baehyeon0420-star/energy-harvesting-research/experiment-logs/experiment-log-2026-08-14.md

# 자연광 에너지 하베스팅 기반 저전력 환경 모니터링 시스템 — 실험 기록

**작성일**: 2026-08-17
**대상 연구계획서**: 자연광 에너지 하베스팅 기반 슈퍼커패시터 및 충전식 배터리의 저장 특성 비교 및 저전력 환경 모니터링 시스템 적용 가능성 평가

---

## 1. 개발 환경 구축

- Arduino IDE 2.3.10 설치
- ESP32 보드 패키지 추가 (Boards Manager URL: `https://raw.githubusercontent.com/espressif/arduino-esp32/gh-pages/package_esp32_index.json`)
- 보드: ESP32 Dev Module (HG-ESP32-DEVKIT V4, ESP32-WROOM-32E)
- 연결: USB-C(C to C) 케이블

---

## 2. ESP32-컴퓨터 연결 확인

Blink 예제에서 `LED_BUILTIN` 미정의 컴파일 에러 발생 → `#define LED_BUILTIN 2`로 해결. 이후 보드에 사용자 LED가 없는 것으로 판단되어 시리얼 출력 방식으로 검증 전환.

```cpp
void setup() {
  Serial.begin(115200);
}

void loop() {
  Serial.println("연결 확인 중...");
  delay(1000);
}
```

**결과**: 1초 간격 정상 출력 확인.

---

## 3. DHT22 (온습도센서) 테스트

- 라이브러리: Adafruit DHT sensor library v1.4.7
- 배선: DATA → GPIO4, VCC → 3.3V, GND → GND

```cpp
#include <DHT.h>
#define DHTPIN 4
#define DHTTYPE DHT22
DHT dht(DHTPIN, DHTTYPE);

void setup() {
  Serial.begin(115200);
  dht.begin();
}

void loop() {
  float h = dht.readHumidity();
  float t = dht.readTemperature();
  if (isnan(h) || isnan(t)) {
    Serial.println("DHT22 읽기 실패");
  } else {
    Serial.print("습도: "); Serial.print(h);
    Serial.print(" %  온도: "); Serial.print(t);
    Serial.println(" C");
  }
  delay(2000);
}
```

**결과**: 습도 32.5~32.6%, 온도 29.1℃ 안정적 측정.

---

## 4. 정전용량식 센서(상시 구동형) 테스트

- 배선: OUT → GPIO34(ADC), VCC → 3.3V, GND → GND

```cpp
#define CAP_SENSOR_PIN 34
void setup() { Serial.begin(115200); }
void loop() {
  int raw = analogRead(CAP_SENSOR_PIN);
  Serial.print("센서 raw 값: ");
  Serial.println(raw);
  delay(1000);
}
```

**결과**: 건조 상태 raw≈3300~3400, 손으로 파지 시 raw≈2500 → 자극 반응 확인.

---

## 5. INA219 (전류센서) 테스트

- 라이브러리: Adafruit INA219 v1.2.3
- 배선: SDA → GPIO21, SCL → GPIO22, VCC → 3.3V, GND → GND

```cpp
#include <Wire.h>
#include <Adafruit_INA219.h>

Adafruit_INA219 ina219;
bool found = false;

void setup() {
  Serial.begin(115200);
  delay(500);
  found = ina219.begin();
}

void loop() {
  if (!found) {
    Serial.println("INA219를 찾을 수 없습니다.");
    delay(1000);
    return;
  }
  float busVoltage = ina219.getBusVoltage_V();
  float current_mA = ina219.getCurrent_mA();
  Serial.print("전압: "); Serial.print(busVoltage);
  Serial.print(" V, 전류: "); Serial.print(current_mA);
  Serial.println(" mA");
  delay(1000);
}
```

**I2C 스캐너 (진단용, 문제 발생 시 사용)**:
```cpp
#include <Wire.h>
void setup() {
  Serial.begin(115200);
  Wire.begin(21, 22);
  delay(500);
  Serial.println("I2C 스캔 시작");
}
void loop() {
  byte count = 0;
  for (byte addr = 1; addr < 127; addr++) {
    Wire.beginTransmission(addr);
    byte error = Wire.endTransmission();
    if (error == 0) {
      Serial.print("발견된 주소: 0x");
      Serial.println(addr, HEX);
      count++;
    }
  }
  if (count == 0) Serial.println("아무 장치도 못 찾음");
  delay(3000);
}
```

**결과**: 전압/전류 정상 출력, 통신 정상 확인.

### 트러블슈팅 메모
- 최초 I2C 미검출 원인: DHT22를 INA219로 착각하고 테스트했던 것으로 판명
- 이후 전압이 8.10V/0mA처럼 "전압은 있는데 전류가 0"으로 뜨는 현상 반복 발생 → **회로가 물리적으로 열려있다는 신호**(개방회로)였음. 원인은 대부분 헐거운 점퍼선 접촉, 또는 브레드보드 A~E/F~J 블록을 혼동해서 다른 블록에 연결한 경우였음

---

## 6. 태양전지 발전 특성 측정 (연구계획서 3.3절)

- 회로: `태양전지(+) → INA219 Vin+ → [INA219] → Vin- → 저항 220Ω → 태양전지(-)`
- 측정일: 2026-08-17(흐림), 2026-08-25(맑음, 직사광선 재측정)

### 결과
- **흐린 날 창가 자연광 + 220Ω 부하**: 전압 0.00V, 전류 0.00mA (검출 안 됨)
- **스마트폰 손전등 대조실험** (약 5cm 거리):

| 조사 조건 | 전압(V) | 전류(mA) |
|---|---|---|
| 근접 조사 (~5cm) | 0.00~0.02 | 0.90 (최댓값) |
| 거리 이격 | 0.00~0.02 | 0.40~0.60 |

- **맑은 날 직사광선 + 220Ω 부하** (2026-08-25): 전압 0.00V(아래 해석 참고), 전류 **평균 약 28.6mA** (28.50~28.90mA 범위, 16회 연속 측정에서 안정적으로 유지)

### 결과 종합

| 조건 | 전류 |
|---|---|
| 흐린 날 창가 (220Ω 부하) | 0.00 mA (미검출) |
| 흐린 날 + 손전등 근접 | 최대 0.90 mA |
| **맑은 날 직사광선 (220Ω 부하)** | **평균 약 28.6 mA** |

### 해석
흐린 날 조건에서는 220Ω 부하 기준 유효 발전량이 관측되지 않았으나, 손전등 대조실험으로 광원 거리(광량)에 비례해 전류가 반응함을 확인 → **회로 및 태양전지 자체는 정상 작동**. 맑은 날 직사광선 조건에서는 흐린 날 손전등 대조실험 최댓값(0.90mA) 대비 **약 30배 이상 높은 전류(28.6mA)**가 안정적으로 측정되어, 광량(발전 조건)이 태양전지 발전량에 미치는 영향이 매우 크다는 것을 실측으로 확인함. 이는 자연광 하베스팅 시스템에서 **날씨(흐림/맑음)에 따른 발전량 변동성이 매우 크므로, 저장소자(슈퍼커패시터)를 통한 에너지 버퍼링이 필수적**이라는 근거를 강화함.

전압이 0.00V로 측정되는 것은 태양전지가 발전을 안 해서가 아니라, 이 회로(태양전지-INA219-저항의 독립 폐회로)가 INA219의 GND 기준점과 전기적으로 분리되어 있어 **버스전압 측정 자체가 의미가 없는 구조**이기 때문임(전류값은 V+/V- 차동 측정이라 이 문제와 무관하게 정확함).

### 개방전압(Voc) 측정 (2026-08-25)

- 회로 변경: 저항 제거, 태양전지(-) → GND 직결, INA219 Vin-는 아무 곳에도 연결하지 않고 개방 → 부하 없이 전압만 측정
- 측정 조건: 직사광선

| 항목 | 값 |
|---|---|
| 개방전압(Voc) | 약 6.31~6.32 V (안정적) |
| 전류 | 0mA 근처 (무부하이므로 정상) |

**해석**: 220Ω 부하 조건에서 역산한 전압(28.6mA × 220Ω ≈ 6.29V)이 개방전압(6.32V)과 거의 동일함 → **220Ω 부하가 이 태양전지 입장에서는 사실상 무시할 만한 가벼운 부하**였다는 뜻. 즉 실제 단락전류(Isc, 최대 전류)는 220Ω 조건에서 측정한 28.6mA보다 훨씬 클 가능성이 높음.

### 최대출력점(MPP) 탐색 — 부하저항 스윕 (2026-08-25)

- 목적: 220Ω 부하가 사실상 무부하 수준이었다는 위 관찰에 따라, 부하저항을 낮춰가며 실제 전력이 최대가 되는 지점을 탐색
- 방법: 동일 회로(태양전지+ → Vin+ → Vin- → 저항 → 태양전지-)에서 저항값만 220Ω → 150Ω → 100Ω → 10Ω으로 변경, 각 조건에서 전류(I) 측정
- 계산: 저항이 유일한 부하이므로 전압은 옴의 법칙으로 역산(`V = I × R`), 전력은 `P = V × I`(= `I²R`)로 계산. 두 방식(V×I, I²R)으로 교차검산하여 일치 확인
- **주의(트러블슈팅)**: 실외/창가 자연광은 짧은 시간에도 조도가 변동하여, 서로 다른 시점에 잰 저항값끼리는 직접 비교가 어려움을 확인함(예: 100Ω을 약해진 빛에서 먼저 재고 220Ω을 그 직후 같은 조도로 다시 재보니 100Ω보다 오히려 낮은 전류가 나옴). **동일 조도 조건에서 연속으로 재측정**하여 아래 결과를 확보함

#### 결과 (강한 직사광선, 동일 조도 조건에서 연속 측정)

| 부하저항 | 평균 전류(I) | 역산 전압(V=I×R) | 전력(P=V×I=I²R) |
|---|---|---|---|
| 220Ω | 28.6 mA | 6.292 V | 179.95 mW |
| 150Ω | 41.8 mA | 6.270 V | 262.09 mW |
| **100Ω** | 58.3 mA | 5.830 V | **339.89 mW** ← 최고점 |
| 10Ω | 71.0 mA | 0.710 V | 50.41 mW |

#### 해석
전류는 저항이 낮아질수록 계속 증가했지만(28.6→41.8→58.3→71.0mA), **전력은 100Ω에서 최댓값을 찍고 10Ω에서 크게 감소**함 — 전형적인 태양전지 I-V 곡선의 종형(bell-shaped) 출력 특성을 실측으로 확인함.

역산 전압을 보면 원인이 뚜렷함: **220Ω→100Ω까지는 전압이 6.29V→5.83V로 거의 유지**되다가, **100Ω→10Ω 구간에서 전압이 5.83V→0.71V로 폭락**함. 반면 이 구간 전류는 58.3→71.0mA로 22%만 증가함. 즉 태양전지가 낼 수 있는 최대 전류(단락전류 Isc)에 가까워지면서, 부하저항을 더 낮춰도 전류는 조금밖에 못 늘어나는데 전압만 크게 깎이는 "무릎(knee)" 구간을 100Ω과 10Ω 사이에서 넘어선 것으로 해석됨. **이 태양전지·조도 조건에서 최대출력점(MPP)은 100Ω 근방**으로 추정됨.

**부가 발견 — 조도에 따른 MPP 저항 이동**: 스윕 도중 조도가 약해졌을 때 별도로 220Ω과 100Ω을 같은 조건에서 비교한 결과, 약한 빛에서는 오히려 220Ω(약 0.61mW)이 100Ω(약 0.42mW)보다 전력이 높았음. 즉 **광량이 강할수록 최적 부하저항이 낮아지고, 광량이 약할수록 최적 부하저항이 높아지는 경향**을 실측으로 확인함. 이는 실제 충전회로 설계 시 고정 저항이 아닌 조도 변화에 대응하는 MPPT(최대출력점 추적) 회로가 필요한 이유를 뒷받침하는 근거로 활용 가능.

**한계**: 10Ω과 100Ω 사이 값(보유 저항 키트 기준 다음 단계가 없음)을 측정하지 못해 정확한 MPP 지점은 100Ω 근방으로 추정만 가능함. 저항 조합(직렬/병렬)을 이용한 중간값 측정, 안정적으로 맑은 날 재현 측정은 후속 과제로 남김.

---

## 7. 슈퍼커패시터 충전 특성 측정 (연구계획서 3.4절)

- 부품: SC5R5105ZC (5.5V / 1.0F)
- 회로: `3.3V(ESP32) → INA219 Vin+ → [INA219] → Vin- → 저항 220Ω → 슈퍼커패시터(+) / 슈퍼커패시터(-) → GND`
- 측정일: 2026-08-17

### 결과

| 경과시간 | 충전전류 |
|---|---|
| 0분 | 14.20 mA |
| 1분 | 9.50 mA |
| 2분 | 7.30 mA |
| 3분 | 6.15 mA |
| 5분 | 4.20 mA |
| 10분 | 2.00 mA |
| 14분 | 0.95 mA |
| 15분 | 0.61 mA |
| 20분 | 0.34 mA |

### 해석
- 초기 전류(14.20mA)는 이론값(3.3V ÷ 220Ω ≈ 15mA)과 근접
- 시간에 따라 지수적으로 감소하는 전형적 RC 충전 곡선 형태
- 20분 시점 전류(0.34mA)가 무부하 노이즈 수준(~0.2~0.3mA)에 근접 → **사실상 충전 완료로 판단**
- 실측 시정수(τ)가 이론값(RC=220초≈3.7분)보다 큰 것은 점퍼선 접촉저항 등 부가 저항 성분에 기인한 것으로 추정

### 결론
슈퍼커패시터는 220Ω 부하 기준 약 20분 이내에 충전 완료. 다음 단계로 방전 특성 측정을 통해 저장된 에너지의 실사용 가능성을 확인할 예정.

---

## 8. 슈퍼커패시터 방전 특성 측정 (2026-08-19)

- 부품: SC5R5105ZC (5.5V / 1.0F), 충전 완료 상태(약 3.14~3.30V)에서 시작
- 회로: `커패시터(+) → 저항 220Ω → Vin- → [INA219] → Vin+ → ESP32 GND / 커패시터(−) → ESP32 GND(별도 핀)`
  - 충전 때와 달리 외부 전원을 완전히 분리하고, 커패시터 자신이 저항을 통해 방전하도록 구성
  - Vin+/Vin- 방향이 충전 때와 반대로 연결되어 전류값이 음수(−)로 측정됨 → **절댓값을 실제 방전전류로 사용**
- 코드: `arduino-code/06_supercap_discharge_test.ino` (경과시간·전압·전류를 CSV 형태로 시리얼 출력)

### 결과

| 경과시간 | 방전전류(절댓값) |
|---|---|
| 0분 | 13.20 mA |
| 약 1.5분 | 9.70 mA |
| 약 3.1분 | 7.10 mA |
| 약 3.6분 | 6.50 mA |
| 약 5.9분 | 4.15 mA |
| 약 12.7분 | 1.01 mA |
| 약 22.9분 | 0.20 mA |

### 해석
- 초기 방전전류(13.20mA)는 충전 완료 시점 전압(약 3.14V) 기준 이론값(3.14V÷220Ω≈14.3mA)과 유사한 수준에서 시작
- 시간에 따라 지수적으로 감소하는 전형적 RC 방전 곡선 형태 (충전 곡선과 대칭적인 개형)
- 약 22.9분 시점에 전류가 0.20mA로 무부하 노이즈 수준까지 감소 → **방전 완료로 판단**
- 방전 소요시간(~23분)이 충전 소요시간(~20분)과 비슷한 수준으로, 동일 저항(220Ω) 부하 기준 충·방전 시정수가 대략 대칭적임을 확인

### 결론
슈퍼커패시터는 220Ω 부하 기준 충전(~20분)과 방전(~23분)이 비슷한 시간 내에 이루어지며, 이는 슈퍼커패시터가 빠른 충·방전이 가능한 저장소자임을 실험적으로 뒷받침함. 다만 절대적인 저장 에너지량은 크지 않아(1.0F, 3.3V 기준 E=½CV²≈5.4J), 장시간 전력 공급보다는 순간적인 부하 대응(예: 무선 통신 순간 전류 보조)에 적합할 것으로 판단됨. LIR2032와의 비교를 통해 이 역할 분담의 타당성을 추후 검증할 예정.

---

## 9. ESP32 센서부 소비전력 측정 — DHT22 (2026-08-20)

- 회로: `+레일 → INA219 Vin+ → [INA219] → Vin- → DHT22 VCC("+") / DHT22 GND, DATA(GPIO4)는 기존과 동일`
- 코드: DHT22 읽기 직전(대기 상태)과 직후(측정 순간)의 INA219 전류를 각각 기록
- 표본 수: 64개

### 결과

| 상태 | 평균 전류 | 범위 |
|---|---|---|
| 대기 상태 | 약 0.00 mA | 노이즈 수준(±0.2mA), 사실상 측정 한계 이하 |
| 센서 측정 순간 | 약 0.90 mA | 0.70 ~ 1.30 mA |

### 해석
DHT22는 대기 중에는 전류를 거의 소비하지 않다가, 실제 온습도 측정을 수행하는 순간에만 약 0.9mA 수준으로 전류가 상승하는 저전력 센서 특성을 실측으로 확인함. 이는 DHT22 데이터시트에 기재된 특성과 부합하며, ESP32의 Deep Sleep 활용 시 센서 측정 구간에서만 짧게 전류가 소모되도록 설계하는 것이 전력 절감에 효과적임을 뒷받침함.

---

## 10. ESP32 센서부 소비전력 측정 — 정전용량식 센서(상시 구동형) (2026-08-20)

- 회로: `+레일 → INA219 Vin+ → [INA219] → Vin- → 정전용량식 센서 VCC / 정전용량식 센서 GND, OUT(GPIO34)는 기존과 동일`
- 코드: `analogRead()` 직전(대기 상태)과 직후(측정 순간)의 INA219 전류를 각각 기록
- 표본 수: 8개

### 결과

| 상태 | 평균 전류 | 범위 |
|---|---|---|
| 대기 상태 | 약 6.95 mA | 6.90 ~ 7.10 mA |
| 측정 순간 | 약 6.93 mA | 6.70 ~ 7.30 mA |

### 해석
DHT22와 달리, 정전용량식 센서는 **대기 상태와 측정 순간의 전류 차이가 거의 없음**(둘 다 약 6.9~7.0mA). 이는 이 센서가 내부 발진회로를 이용한 정전용량 감지 방식이라, 전원이 켜져 있는 동안 계속 회로가 동작하며 일정한 전류를 소모하기 때문으로 판단됨. 즉 DHT22처럼 "측정하지 않을 때는 절전"되는 구조가 아님.

**설계적 시사점**: 이 센서는 ESP32가 Deep Sleep에 들어가도 전원이 계속 공급되면 약 7mA를 지속적으로 소모하므로, 실제 저전력 운용을 위해서는 Deep Sleep 진입 전 이 센서의 전원 자체를 (예: MOSFET 스위치로) 차단하는 설계가 필요함. DHT22(약 0.9mA, 측정 순간만) 대비 훨씬 큰 상시 부하이므로 전력 예산 설계 시 우선적으로 고려해야 할 항목.

---

## 11. ESP32 Deep Sleep 사이클 타이밍 측정 (2026-08-20)

### 측정 방법
ESP32 자체(칩)의 Deep Sleep 전류는 INA219+USB 시리얼 구성만으로는 직접 측정이 불가능함 (Deep Sleep 중에는 CPU가 정지하여 자기 자신의 소비전류를 읽고 보고할 수 없고, 보드 전체 전류를 재려면 USB 전원 경로를 물리적으로 개조해야 하나 이번 연구 범위에서는 제외함). 따라서 **① 각 동작 단계의 소요 시간은 코드로 직접 측정**하고, **② 전류값은 Espressif 공식 데이터시트 및 실측 비교 자료를 인용**하여 결합하는 방식으로 에너지를 추정함.

- 코드: `arduino-code/09_deepsleep_timing.ino`
- 테스트 조건: Sleep 구간 30초(테스트용, 실제 운용 시 600초=10분 예정), Wake 시 DHT22+정전용량식 센서 측정 → 데이터 포맷팅 → 시리얼 출력 → 재취침

### 타이밍 측정 결과 (3회 반복, 결과 일관됨)

| 단계 | 소요 시간 |
|---|---|
| 센서 측정 (DHT22+정전용량식 센서) | 6 ms |
| 데이터 처리(포맷팅) | 0 ms (측정 한계 이하) |
| 전송(시리얼 출력) | 0 ms (측정 한계 이하) |
| **전체 Wake 구간** | **7 ms** |

3회 반복 측정에서 편차 없이 동일한 값(6ms/7ms)이 나와 재현성이 높음을 확인함.

### 참고 전류값 (Espressif 데이터시트 및 실측 비교자료 인용)

| 상태 | 전류(참고값) | 출처 |
|---|---|---|
| Deep Sleep (ESP32 칩 자체, 이상적 조건) | 약 10 μA | [Espressif 공식 데이터시트](https://www.espressif.com/sites/default/files/documentation/esp32_datasheet_en.pdf) |
| Deep Sleep (DevKit 보드 실측, 레귤레이터/USB-시리얼 브릿지 포함) | 약 5 ~ 15 mA | [Hubble Network 실측 비교 자료](https://hubble.com/community/guides/esp32-power-consumption-datasheet-vs-reality/) |
| Active (240MHz, 무선 미사용) | 약 30 ~ 68 mA | [Espressif 공식 데이터시트](https://www.espressif.com/sites/default/files/documentation/esp32_datasheet_en.pdf) |

### 에너지/평균전류 추정 (10분 주기 기준)
Wake 구간(7ms)이 전체 주기(600초) 대비 극히 짧아(듀티비 약 0.0012%), Active 구간이 평균 소비전류에 기여하는 비중은 무시할 수준으로 작음. 따라서 한 주기의 평균 소비전류는 사실상 Deep Sleep 전류값에 의해 결정됨:

$$
I_{avg} \approx I_{sleep} \quad (\because t_{active} \ll t_{sleep})
$$

**중요한 발견**: 이상적인 ESP32 칩 자체의 Deep Sleep 전류(~10μA)와, 지금 사용 중인 **DevKit 보드의 실제 Deep Sleep 전류(~5~15mA, 온보드 레귤레이터·USB-시리얼 칩 등의 상시 소모 포함)** 사이에는 약 500~1500배의 차이가 있음. 즉 Deep Sleep 코드 자체를 아무리 최적화해도, **개발보드에 내장된 주변 회로의 상시 소비전력이 실제 평균 소비전력을 지배**하는 구조임을 확인함.

### 결론 및 설계 시사점
1. Wake 구간(7ms)이 매우 짧아 센서 측정·데이터 처리 자체의 최적화 여지는 크지 않음
2. 실제 저전력 운용을 위해서는 Deep Sleep 코드보다 **하드웨어 선정(베어 모듈 사용, 불필요한 온보드 레귤레이터/USB칩 배제)**이 훨씬 큰 영향을 미침 — 최종 통합 시스템에서는 개발보드 대신 베어 ESP32 모듈 사용을 고려할 필요가 있음
3. 정전용량식 센서(상시 ~7mA)를 Deep Sleep 중 전원 차단하는 설계(10번 항목)와 함께, 보드 자체의 상시 소모 절감도 병행되어야 실질적인 절전 효과를 기대할 수 있음

---

## 12. 슈퍼커패시터 자가방전 측정 (완료, 2026-08-20~22)

- 방법: 커패시터를 완전 충전(전류 0.2~0.6mA 수준) 후 브레드보드에서 완전히 분리, 체크 시점마다 잠깐만 재연결하여 전압만 측정 후 다시 분리
- 측정 회로(체크 시에만 잠깐 연결, **+레일/외부전원 절대 연결 안 함**): `커패시터(+) → 저항 220Ω → INA219 Vin- / INA219 Vin+ → GND / 커패시터(-) → GND`
- 주의: 체크 시 전류가 0으로 안정될 때까지 기다리지 말고, **연결 직후 첫 값만 기록하고 바로 재분리**할 것 (오래 연결해두면 저항을 통해 실제로 방전되어버림)

| 경과시간 | 전압 | 전압 유지율(Vt/V0×100) | 비고 |
|---|---|---|---|
| 0시간 (2026-08-20 약 17:16) | 3.30 V | 100% | 충전 완료 직후 기준점 |
| 1시간 (약 18:16) | 3.28 V | 99.4% | |
| 6시간 (약 23:16) | 3.22 V | 97.6% | |
| 약 22시간 (2026-08-21 약 15:32) | 3.24 V | 98.2% | 6시간 값보다 소폭 높으나 측정 노이즈(±0.02~0.04V) 범위 |
| 48시간 (2026-08-22 약 16:56) | 3.23 V | 97.9% | 최종값 |

### 결론
48시간(이틀) 방치 후 전압 유지율 약 97.9%로, **슈퍼커패시터가 자가방전에 비교적 강한 특성**을 보임. 흐린 날이 며칠 지속되어도 저장된 에너지 자체의 자연 손실은 크지 않다는 것을 실측으로 확인함 (다만 16번 항목의 에너지 수지 모델에서는 자가방전보다 상시 부하 소비가 훨씬 지배적인 요인임을 별도로 확인).
| 24시간 |  |  |
| 48시간 |  |  |

## 13. LIR2032 초기 상태 확인 (2026-08-21)

- 부품(TP4056 충전모듈 HW-373, CR2032/LIR2032 코인홀더) 배송 도착
- **문제 발생**: TP4056 충전모듈이 USB 연결 시 LED가 전혀 반응하지 않음 (케이블/포트는 별도로 정상 확인됨) → 충전 실험은 보류, 원인 불명(불량 의심)
- 대안으로 충전 없이 **LIR2032의 초기(출하 시) 전압을 배선 측정으로 확인**
  - 회로: 슈퍼커패시터 방전 실험과 동일한 배선 재사용 — `LIR2032(+) → 저항 220Ω → INA219 Vin- / INA219 Vin+ → GND / LIR2032(-) → GND`
  - 브레드보드에 정상적으로 꽂아 측정 (접촉 안정적)

### 결과

| 항목 | 값 |
|---|---|
| 초기 전압 | 약 3.28~3.29 V |
| 부하 전류(220Ω 기준) | 약 3.2~3.7 mA (거의 일정, 큰 감소 없음) |

### 해석
- LIR2032는 출하 시 완충(4.2V)이 아닌 **부분충전 상태(약 3.28V)**로 온 것으로 보임 (안전을 위한 일반적인 배송 관행)
- 이론값(3.28V÷220Ω≈14.9mA) 대비 실측 전류(약 3.4mA)가 크게 낮음 → 슈퍼커패시터 대비 **LIR2032의 내부저항(ESR)이 훨씬 크다는 정황적 근거**로 해석 가능 (정밀 ESR 측정은 추후 별도 진행 필요)
- 슈퍼커패시터(1F)와 달리 짧은 시간 동안 전류가 거의 감소하지 않음 → **훨씬 큰 에너지 용량(40mAh)**을 가진 저장소자의 특성을 보여줌

## 16. 하루 에너지 수지 모델 (2026-08-21)

지금까지 측정한 개별 데이터(9~10번 항목)를 종합하여, ESP32가 10분마다 깨어나 센서를 측정·전송하는 운용 시나리오를 가정하고 하루 소비 에너지를 계산함. 계산은 실측값을 그대로 사용하되, 정확한 실측이 불가능했던 항목(ESP32 칩 자체 Deep Sleep 전류, Active 전류)은 11번 항목에서 인용한 Espressif 데이터시트/실측비교자료 값을 사용함.

### 시나리오 1 — 현재 상태 (최적화 없음)
정전용량식 센서가 상시 전원 공급(스위치 없음), ESP32는 DevKit 보드(온보드 레귤레이터·USB칩 포함) 사용 가정.

| 소모 요인 | 계산 | 일일 에너지 |
|---|---|---|
| 정전용량식 센서 상시 소모 | 7mA × 24h × 3.3V | 554 mWh |
| ESP32 DevKit Deep Sleep 상시 소모 | 10mA(5~15mA 대푯값) × 24h × 3.3V | 792 mWh |
| **합계** | | **≈ 1,346 mWh/day** |

### 시나리오 2 — 최적화 적용
정전용량식 센서를 측정 순간에만 전원 공급(MOSFET 스위치 등), ESP32는 베어 모듈(온보드 주변회로 없음) 사용 가정.

| 소모 요인 | 계산 | 일일 에너지 |
|---|---|---|
| ESP32 베어모듈 Deep Sleep | 10μA × 24h × 3.3V | 0.79 mWh |
| Wake 구간(센서측정+처리+전송, 7ms×144회/일) | 약 50mA(Active 참고값) × 7ms × 144회 × 3.3V | 0.05 mWh |
| **합계** | | **≈ 0.84 mWh/day** |

### 핵심 결과
**하드웨어 선택(베어 모듈 + 센서 전원 스위치)만으로 일일 소비 에너지가 약 1,346배 감소** (1,346 mWh → 0.84 mWh). 이는 11번 항목에서 확인한 "Deep Sleep 코드 최적화보다 하드웨어 선택이 지배적"이라는 결론을 정량적으로 뒷받침함.

### 흐린 날 생존 가능 기간 추정
슈퍼커패시터 저장에너지(E=½CV², C=1.0F, V=3.3V 기준 약 5.4J ≈ 1.5mWh)를 기준으로, 흐린 날(발전량≈0, 6절 참고) 지속 시 저장 에너지만으로 버틸 수 있는 기간(N_days ≈ E_stored/E_consume,day):

| 시나리오 | 생존 가능 기간 |
|---|---|
| 시나리오 1 (최적화 없음) | 1.5mWh ÷ 1,346mWh/day ≈ **약 1시간** |
| 시나리오 2 (최적화 적용) | 1.5mWh ÷ 0.84mWh/day ≈ **약 1.8일** |

### 결론
동일한 저장 용량(슈퍼커패시터)으로도, 시스템 설계(하드웨어 선택 + 상시부하 센서의 전원 관리)에 따라 흐린 날 생존 가능 기간이 1시간에서 약 2일로 극적으로 달라짐. 이는 본 연구의 핵심 주장 — *"제한된 하베스팅 에너지 환경에서는 저장소자 종류보다 시스템 전체의 에너지 병목 제거가 우선"* — 을 뒷받침하는 정량적 근거임.

**주의**: 이 모델은 실측값(센서 소비전력, Deep Sleep 타이밍)과 참고문헌값(칩 자체 전류)을 결합한 추정치이며, 실제 통합 시스템 구성 후 검증 필요.

## 18. 슈퍼커패시터 내부저항(ESR) 측정 (2026-08-22)

### 방법
부하 연결 전(V_open, 무부하)과 연결 직후(V_loaded, 부하 인가 순간)의 전압차와 전류로 근사 계산: R_int ≈ ΔV/I. 12번 항목의 자가방전 실험에서 남은 충전 상태(약 3.28V)를 그대로 활용. 부하 저항값을 220Ω → 100Ω → 10Ω 순으로 낮춰가며 반복 측정 — 저항이 작을수록 ΔV(신호)가 측정 노이즈(±0.02~0.04V) 대비 커져서 정밀도가 개선되는지 확인하기 위함.

### 결과 — 저항값별 반복 측정

| 부하저항 | 반복 | 개별 R_int 값 | 평균 | 변동계수(CV) |
|---|---|---|---|---|
| 220Ω | 5회 | 4.95, 5.49, 5.68, 5.95, 2.38 Ω | 4.89 Ω | 약 27% |
| 100Ω | 3회 | 3.53, 3.40, 2.99 Ω | 3.31 Ω | 약 7% |
| 10Ω | 5회 | 4.59, 4.15, 3.96, 3.60, 3.61 Ω | 3.98 Ω | 약 9% |
| **전체(13회)** | | | **≈ 4.18 Ω** | |

### 해석
- **부하저항을 낮출수록 측정 편차(CV)가 크게 감소**함 (220Ω: 27% → 100Ω/10Ω: 7~9%). 이는 낮은 저항일수록 전류가 커져 ΔV 신호가 INA219 측정 노이즈 대비 상대적으로 커지기 때문으로, 예상한 방법론적 개선이 실제로 유효함을 확인함
- 100Ω과 10Ω 두 독립된 부하 조건에서 유사한 범위(3.3~4.0Ω)로 수렴 — 서로 다른 측정 조건에서의 일관된 결과는 측정 신뢰성을 뒷받침하는 교차검증으로 볼 수 있음
- 220Ω 조건의 평균(4.89Ω)이 다소 높게 나온 것은 표본 5 중 1개(2.38Ω)의 이상치 영향이 큼 — 소수 샘플 + 낮은 신호 대비 노이즈 조건에서는 이상치에 취약함을 보여주는 사례로, 측정 방법 개선의 필요성을 뒷받침하는 근거로 활용 가능

### 결론
**슈퍼커패시터 ESR ≈ 약 3.5~4Ω** (100Ω/10Ω 조건 기준, 3가지 부하조건 13회 반복 측정 종합). 연구계획서 4.7절에 명시된 대로 이 값은 저장소자의 절대적 내부저항이라기보다 실험 조건에서의 비교 지표이나, 여러 조건에서의 수렴을 통해 상당한 신뢰도를 확보함.

## 19. DC-DC 스텝업 모듈 + 전압 레귤레이터 통합 시도 (실패, 2026-08-22)

### 목표
슈퍼커패시터 → DC-DC 스텝업 모듈(승압) → LD1117-3.3 레귤레이터(정전압화) → ESP32로 이어지는 전체 전력 체인을 물리적으로 구성해, 통합 시스템이 실제로 동작하는지 검증하려 함.

### 부품
- DC-DC 스텝업 모듈 (SMD 소형 보드, 핀: VI+/VI-/VO+/VO-)
- LD1117-3.3 전압 레귤레이터 (TO-220 패키지, 핀: GND-VOUT-VIN)

### 진행 및 결과
- **DC-DC 모듈 단독 테스트는 성공**: 슈퍼커패시터를 VI+/VI-에 연결했을 때 VO+에서 4.94V 출력 확인 → 모듈 자체는 정상 작동
- **레귤레이터와 연동 시 반복 실패**: DC-DC 출력을 LD1117 VIN에 연결하는 배선으로 재구성할 때마다 결과가 0V이거나, `8.10V/0.00mA`(전압은 뜨는데 전류가 0인 개방회로 신호, 5번 항목 참고)로 나옴. 배선 순서를 여러 차례 재확인했음에도 동일하게 재현됨
- GND 자리 부족(ESP32 물리핀·브레드보드 컬럼 모두 이미 다른 선으로 채워짐), DC-DC 모듈 자체의 SMD 패드도 매우 작아 추가 점퍼선을 꽂을 자리가 부족한 물리적 한계에 봉착

### 추정 원인 (미확인 가설)
DC-DC 모듈이 SMD(표면실장) 타입 보드로, **브레드보드에 바로 꽂아 쓰도록 설계된 것이 아니라 핀헤더를 납땜한 뒤 사용하는 것을 전제로 한 부품**일 가능성이 높음. 이 경우 지금처럼 점퍼선을 패드에 직접 접촉시키는 방식 자체가 접촉 불량의 근본 원인일 수 있음 — 납땜 없이는 신뢰성 있는 연결이 어려울 것으로 판단되나, 확정적으로 검증하지는 못함.

### 결론
물리적 통합(4단계 연속 체인) 실험은 이번 학기 범위에서는 **보류**하고, 대신 이미 확보된 개별 컴포넌트 실측 데이터(태양전지, 슈퍼커패시터 충/방전/자가방전/ESR, 센서·MCU 소비전력)를 근거로 한 계산 기반 종합(16번 항목 에너지 수지 모델)으로 시스템 전체 성능을 추정하는 방향으로 전환함. 이후 더 단순한 형태(DC-DC/레귤레이터 없이 커패시터 직결)의 실측 증명을 별도로 시도함 — 20번 항목(아래) 참고.

**후속 과제**: 핀헤더 납땜 후 재시도, 또는 브레드보드 프로토타이핑에 적합한 DIP 타입 DC-DC/레귤레이터 모듈로 교체.

## 20. 슈퍼커패시터 직결 구동 증명 실험 — 시도 및 방법론 확립 (2026-08-23)

### 목표
슈퍼커패시터에 저장된 에너지만으로 ESP32+센서 시스템이 실제로 구동되는지를 실측으로 증명 (DC-DC/레귤레이터 통합 없이, 커패시터를 ESP32 3V3/GND에 직결하는 단순화된 구성).

### 배선
- 충전: 7번 항목과 동일한 회로 재사용 (3.3V → INA219 Vin+ → Vin- → 저항220Ω → 커패시터+ / 커패시터- → GND)
- 완충 확인: **3.29V / 0.40mA** (노이즈 수준, 완충 판정 — 12번 항목 자가방전 실험 이후 방전시키지 않아 잔여 충전 상태에서 시작)
- 직결 배선: 커패시터+ → 브레드보드 +레일, 커패시터- → 기존 GND 연결 재사용. ESP32 물리적 3V3/GND 핀에 이미 여러 선(INA219 VCC/GND, DHT22, 정전용량식 센서 등)이 꽂혀 있어 자리가 없었으므로, **레일(이미 3V3과 연결된 상태)을 경유**해 새 선을 추가

### 트러블슈팅 1 — 브레드보드 +레일 구간 분리
커패시터+를 +레일에 연결했음에도 전압이 3.29V → 3.01V로 서서히 하락 (자가방전 패턴과 동일한 신호). 원인은 **브레드보드 +레일이 물리적으로 중간에 끊긴 구간**에 꽂혀 있어 ESP32 3V3과 실제로는 연결되지 않았던 것으로 확인. 같은 레일 구간(끊김 없이 이어진 쪽)으로 옮겨 연결한 뒤 전압이 3.25~3.26V로 더 이상 하락하지 않고 안정적으로 유지됨을 확인 → 레일 연결 성공.

### 트러블슈팅 2 — USB 재연결 기반 검증 방법의 근본적 한계
당초 계획: `09_deepsleep_timing.ino`의 `RTC_DATA_ATTR bootCount`가 Deep Sleep 중에는 유지되고, 전원이 완전히 끊겨야만 리셋되는 특성을 이용해 — USB를 뽑고 커패시터만으로 일정 시간 대기한 뒤 재연결했을 때 bootCount가 이어져 있으면 "커패시터가 끊김 없이 전원을 공급했다"는 증거로 삼으려 함.

- 2분 대기 후 재연결 → bootCount **3에서 2로 감소**, `rst:0x5 (DEEPSLEEP_RESET)` 코드는 그대로 유지
- 5분 대기 후 재연결(별도 시행) → bootCount **9에서 2로 감소**, 역시 `rst:0x5` 코드 유지

두 시행 모두 대기시간(2분 vs 5분)과 무관하게 동일하게 "2"로 귀결됨 → 커패시터가 도중에 방전되어 죽은 것이 아니라, **USB를 다시 꽂아 시리얼 모니터가 포트를 여는 순간 자체가 ESP32를 리셋시키는 것**으로 판단 (아두이노 IDE가 포트를 열 때 DTR/RTS 신호로 자동 리셋 회로의 EN 핀을 토글하는 것으로 추정). 즉 **"USB를 뽑았다 다시 꽂아서 bootCount로 확인"하는 검증 방식은 이 하드웨어에서 원천적으로 신뢰할 수 없음**을 실측으로 확인함. (참고: 별개로, 배선을 만지다가 접촉 불량으로 리셋되는 사례도 1회 관찰됨 — 브레드보드 접촉 안정성이 이런 종류의 실험에서 중요한 변수임을 재확인)

### 트러블슈팅 3 — 대안 지표 탐색
- **ESP32 보드의 빨간 전원 LED**: USB 케이블 제거 시 즉시 꺼지지 않고 3~4초에 걸쳐 서서히 소등됨 → 5V(USB) 라인에 물린 필터 커패시터가 방전되는 시간으로 판단되며, 3.3V(슈퍼커패시터)쪽 상태와는 무관 → **검증 지표로 사용 불가 확인**
- **GPIO 제어 LED**: 보유 부품 중 LED가 없어 즉시 시도 불가 (구매 필요)
- **멀티미터**: 보유 여부 미확인, 학교 실험실 확인 예정

### 결론 및 다음 단계
USB 시리얼 기반 검증이 재연결 시 리셋을 유발해 사용할 수 없다는 것을 실측으로 확인함 — 단순한 결과는 못 얻었지만, 이는 오히려 **왜 독립적(비침습적)인 측정 수단이 필요한지를 실측으로 뒷받침하는 방법론적 근거**로 활용 가능. 다음 시행 시 아래 중 하나로 재시도 예정:
1. **LED(+저항) 구매 후 GPIO 제어 방식으로 "코드 동작 중"을 시각적으로 표시** (권장 — 저비용, 코드가 실제로 실행되고 있음을 직접 확인 가능)
2. 멀티미터로 커패시터 전압을 독립적으로 실시간 관찰 (ESP32-WROOM-32 최소 동작전압 약 3.0V를 판정 기준선으로 사용)
3. 데이터 전용 USB 케이블로 시리얼 연결을 끊지 않고 지속 관찰 (재연결 자체가 없어 리셋 문제 회피 가능)

---
