baehyeon0420-star/energy-harvesting-research/arduino-code/08_capacitive_sensor_power_measurement.ino

// 정전용량식 센서(상시 구동형) 소비전류 측정 (대기 상태 vs 측정 순간)
// 회로: +레일 -> INA219 Vin+ -> [INA219] -> Vin- -> 정전용량식 센서 VCC
//       정전용량식 센서 GND, OUT(GPIO34)는 기존과 동일하게 연결

#include <Wire.h>
#include <Adafruit_INA219.h>

#define CAP_SENSOR_PIN 34
Adafruit_INA219 ina219;

void setup() {
  Serial.begin(115200);
  delay(500);
  ina219.begin();
}

void loop() {
  float idle_mA = ina219.getCurrent_mA();
  int raw = analogRead(CAP_SENSOR_PIN);
  float active_mA = ina219.getCurrent_mA();

  Serial.print("대기전류: "); Serial.print(idle_mA);
  Serial.print(" mA | 측정순간 전류: "); Serial.print(active_mA);
  Serial.print(" mA | 센서 raw: "); Serial.println(raw);

  delay(2000);
}
