baehyeon0420-star/energy-harvesting-research/(commit log)

2026-08-17 Initial commit: 측정 시스템 구축 및 태양전지/슈퍼커패시터 예비실험 기록
    - ESP32/DHT22/정전용량식 센서/INA219 연결 테스트 코드
    - 태양전지 발전 특성 예비실험 결과
    - 슈퍼커패시터 충전 특성 측정 결과
2026-08-19 슈퍼커패시터 방전 특성 측정 결과 추가
    - 06_supercap_discharge_test.ino 코드 추가
    - 방전 실험 데이터(0~22.9분, 13.2mA→0.20mA) 및 해석 기록
    - README/실험기록 진행 상황 체크리스트 업데이트
2026-08-19 회로도 및 LICENSE 추가
    - docs/circuit-diagram.png: 전체 시스템 개념도 + 슈퍼커패시터 충/방전 회로도
    - LICENSE: MIT
    - README에 회로도 링크 및 폴더 구조 갱신
2026-08-20 DHT22 및 정전용량식 센서 소비전류 측정 결과 추가
    - 07_dht22_power_measurement.ino, 08_capacitive_sensor_power_measurement.ino 추가
    - DHT22: 대기 ~0mA, 측정순간 ~0.9mA (측정 순간에만 전류 소모)
    - 정전용량식 센서: 대기/측정 모두 ~6.9~7.0mA (상시 전류 소모, Deep Sleep 시 전원 차단 필요 시사)
    - README 진행 상황 및 코드 목록 갱신
2026-08-20 ESP32 Deep Sleep 타이밍 측정 및 전력 분석 추가
    - 09_deepsleep_timing.ino 추가 (Wake/센서측정/처리/전송 단계별 타이밍)
    - 3회 반복 측정 결과: Wake 구간 7ms로 매우 짧고 재현성 높음
    - Espressif 데이터시트 및 실측 비교자료를 인용해 전류값 결합
    - 핵심 발견: DevKit 보드의 상시 소비전류(~5~15mA)가 칩 자체 이상값(~10uA)보다
    수백~천 배 큼 -> 실제 저전력화는 하드웨어(베어 모듈) 선정이 더 중요함을 확인
    - README 진행상황/코드 목록 갱신
2026-08-20 슈퍼커패시터 자가방전 실험 시작 및 전체 로드맵 정리
    - 0시간 기준점(3.30V) 기록, 1/6/12/24/48시간 체크 표 준비
    - 남은 전체 작업 순서(진행중/대기중/조건부/후속) 문서화
2026-08-20 요약표(0번 항목) 최신 상태로 갱신 - 오늘 진행분 반영 누락 수정
2026-08-20 자가방전 1시간 데이터(3.28V) 기록 및 측정 회로 설명 수정
2026-08-21 자가방전 6시간(3.22V), 22시간(3.24V) 데이터 기록
2026-08-21 LIR2032 초기전압 측정 및 TP4056 불량 이슈 기록
    - TP4056 충전모듈 LED 무반응 문제 (케이블/포트는 정상 확인)
    - 대안으로 커패시터 방전 배선 재사용해 LIR2032 초기전압 측정 (약 3.28V)
    - 이론 전류값과 실측 차이로 LIR2032 ESR이 슈퍼커패시터보다 클 가능성 시사
    - 요약표 및 다음 계획에 TP4056 해결을 최우선 과제로 반영
2026-08-21 연구 방향 전환: 슈퍼커패시터 중심 에너지 효율 분석으로 범위 조정
    - TP4056 이슈로 LIR2032 정식 충·방전 비교를 후속 과제로 이동
    - README/실험기록에 전환 배경과 근거 명시
    - 다음 계획을 에너지 수지 모델·병목 분석 중심으로 재구성
    - 요약표 및 섹션 번호 정리
2026-08-21 하루 에너지 수지 모델 및 흐린 날 생존기간 추정 추가
    - 시나리오1(최적화 없음) vs 시나리오2(베어모듈+센서 스위치) 비교
    - 일일 소비 에너지 1,346mWh -> 0.84mWh (약 1,346배 개선)
    - 슈퍼커패시터 저장에너지 기준 흐린 날 생존기간: 1시간 -> 약 1.8일
    - README/요약표 진행상황 반영
2026-08-21 향후 발전 방향(단기/중기/장기) 저장
    - 단기: 베어모듈로 예측치 실측 검증
    - 중기: 적응형 전력관리, 발전량 개선(태양전지 대안 비교)
    - 장기: 저장/발전 소자 선택 포함한 저전력 시스템 설계 실험 확장
2026-08-22 자가방전 최종값 및 ESR 측정 결과(13회 반복) 추가
    - 자가방전 48시간 최종값(3.23V, 유지율 97.9%) 기록, 실험 완료 처리
    - ESR: 220Ω/100Ω/10Ω 세 조건 13회 반복 측정, 저항 낮출수록 편차 감소 확인
    (220Ω CV 27% -> 100Ω/10Ω CV 7~9%)
    - 최종 ESR 약 3.5~4Ω으로 수렴, 교차검증으로 신뢰도 확보
    - 요약표/README 진행상황 갱신
2026-08-23 직결 구동 증명 실험 시도 및 방법론 발견 기록 (레일 분리, USB 재연결 리셋 이슈)
2026-08-25 DC-DC/레귤레이터 통합 실패 기록 추가 (2026-08-22, 기록 누락분 보완)
2026-08-25 태양전지 맑은 날 재측정 결과 추가 (평균 28.6mA, 흐린 날 대비 약 30배)
2026-08-25 README 진행상황: 태양전지 측정 완료 문구 최신화
2026-08-25 태양전지 개방전압(Voc) 측정 결과 추가 (약 6.32V)
2026-08-25 태양전지 최대출력점(MPP) 부하저항 스윕 실험 결과 추가 (220/100/10Ω, 조도별 MPP 이동 발견)
2026-08-25 MPP 스윕에 150Ω 데이터 추가, 전압 역산값 포함한 표로 재정리 및 검산
2026-08-25 README에 데이터 시각화 포트폴리오 페이지 링크 추가
2026-08-27 연구 방향 원칙 확정: 넓히지 않고 깊게 파는 방향으로 (2026-08-25)
2026-09-19 실험 외 내용 정리: 진행 상황·연구 방향·계획 섹션 삭제
    - 실험 로그에서 §0 진행 상황 요약, §14 연구 방향 전환, §15 다음 계획,
    §17 향후 발전 방향, §21 발표/논문 정리 방향, §22 연구 방향 원칙 확정 삭제
    - README에서 연구 범위 조정 안내와 진행 상황 체크리스트 삭제
